overjamaya/Project_design/README.md

# Project_design

### codigo
se encuentran los archivos de programacion del sensor y conexion a wifi.

### Schematic_PCB
Se encuentran los archivos de esquematicos y PCB

### Gerber
Archivos de fabricacion de la placa
