overjamaya/Project_design/Schematic_PCB/Schematic.pdf

# VDD33V¹ ²

## FLASH

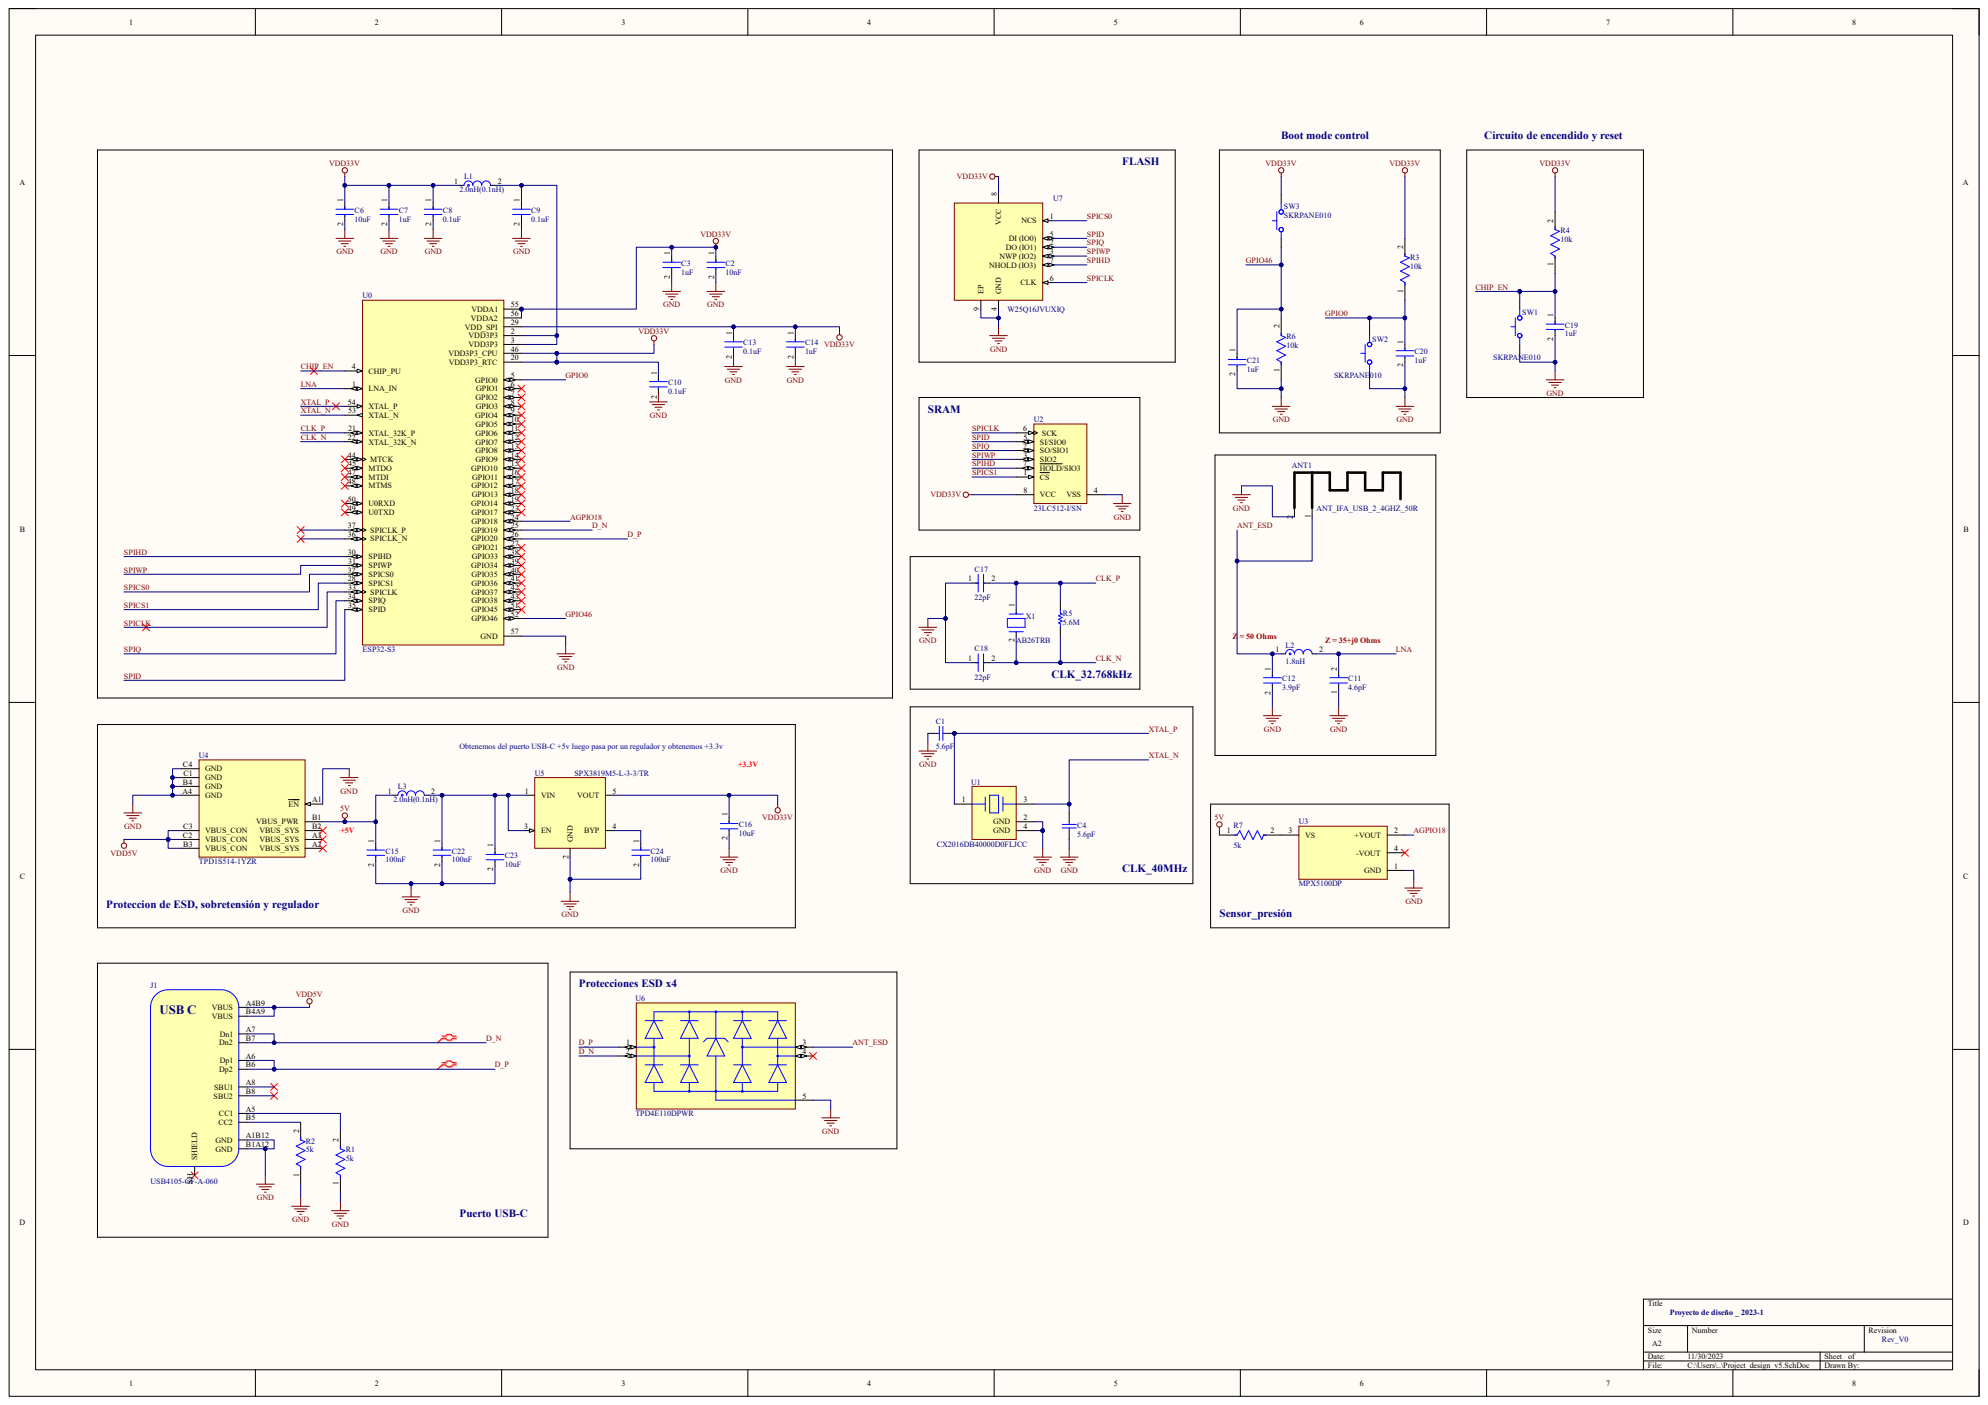
[picture p33: page 1]

Circuito de encendido y reset
VDD33V 1 2

Obtenemos del puerto USB-C +5v luego pasa por un regulador y obtenemos +3.3v

Proteccion de ESD, sobretensión y regulador
