overjamaya/Project_design/Schematic_PCB/Capas_componentes.PDF

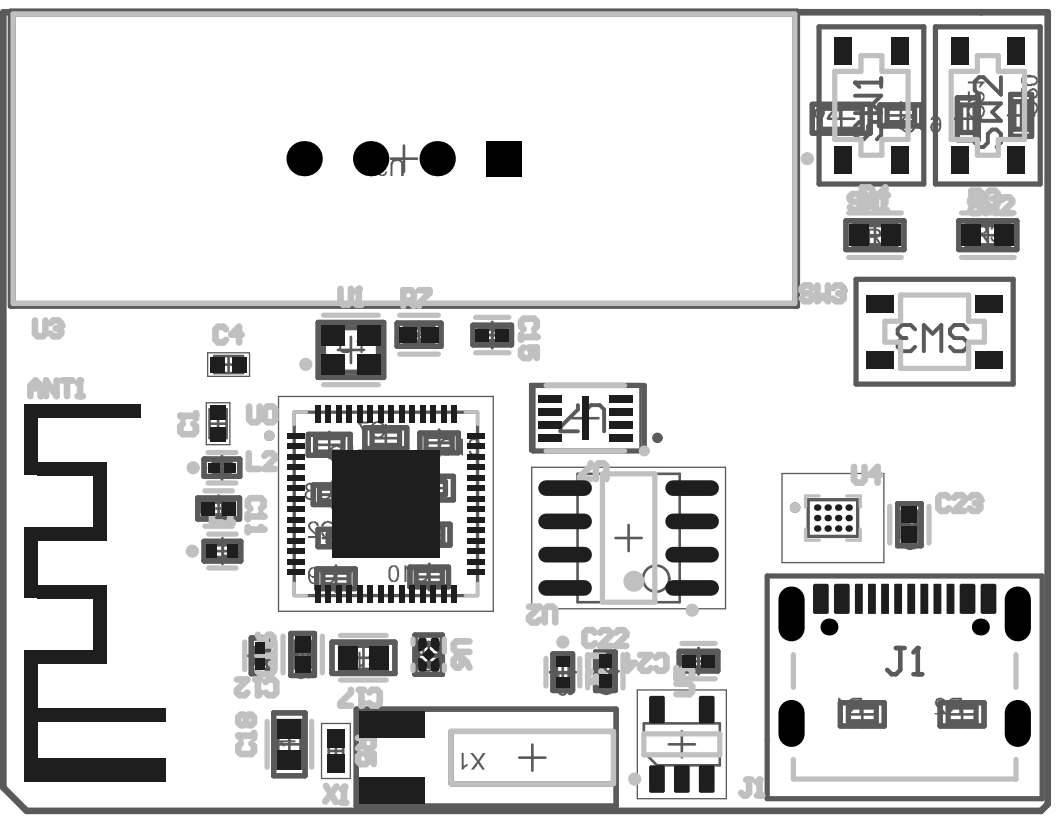
[picture p34: page 1]

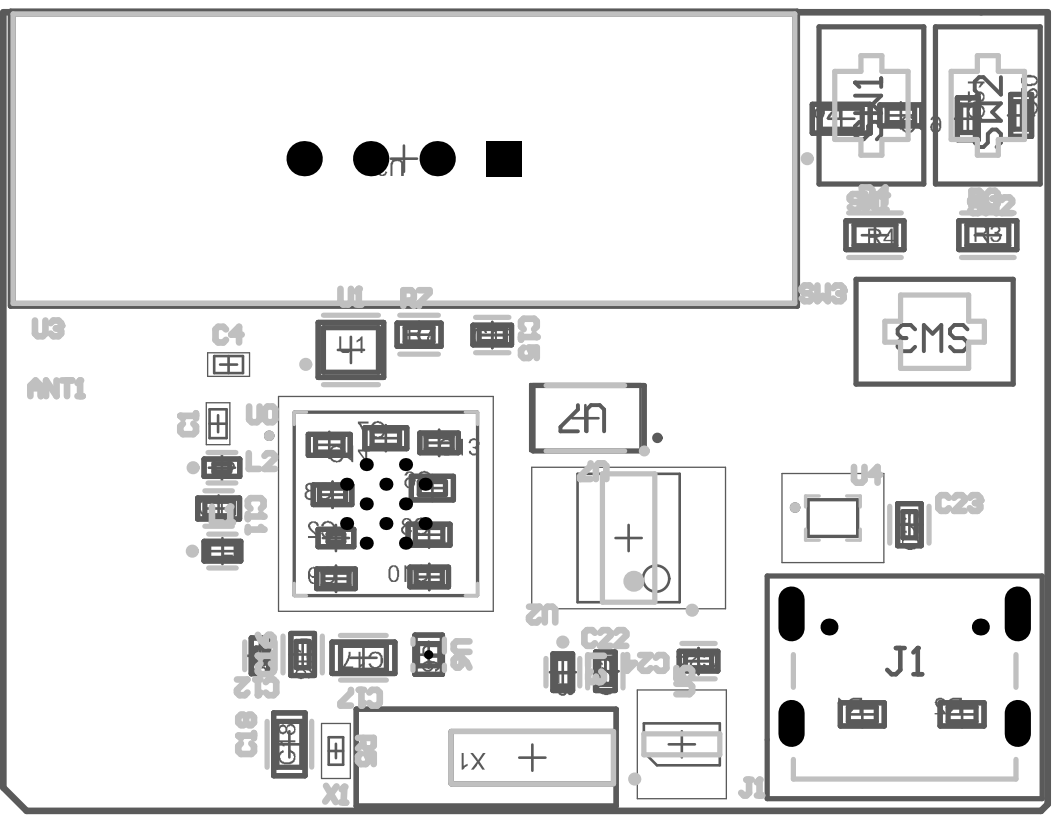
[picture p35: page 2]

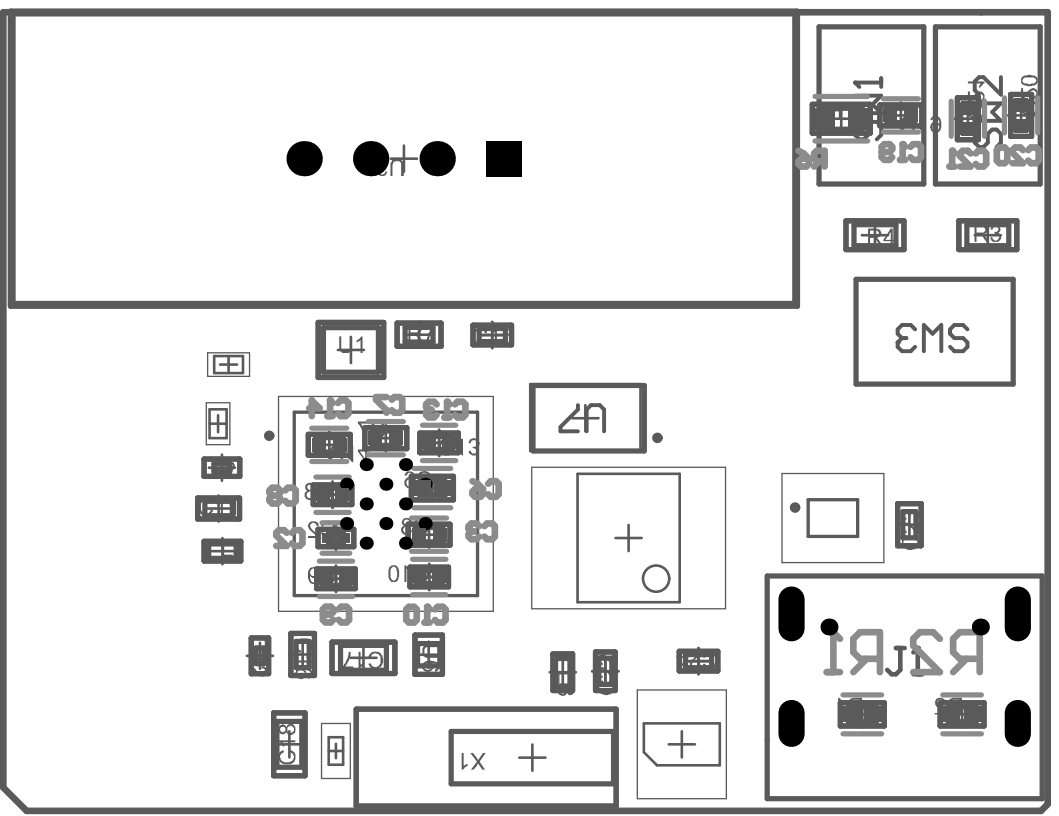
[picture p36: page 4]
