overjamaya/Project_design/(list of files, drawings)

Other design files:
Schematic_PCB/Project_design.PcbDoc
Schematic_PCB/Project_design.SchDoc
